vgoncearencu/diy-ltcc/diy-ltcc.brd

## EAGLE design diy-ltcc.brd (2018-06-22)

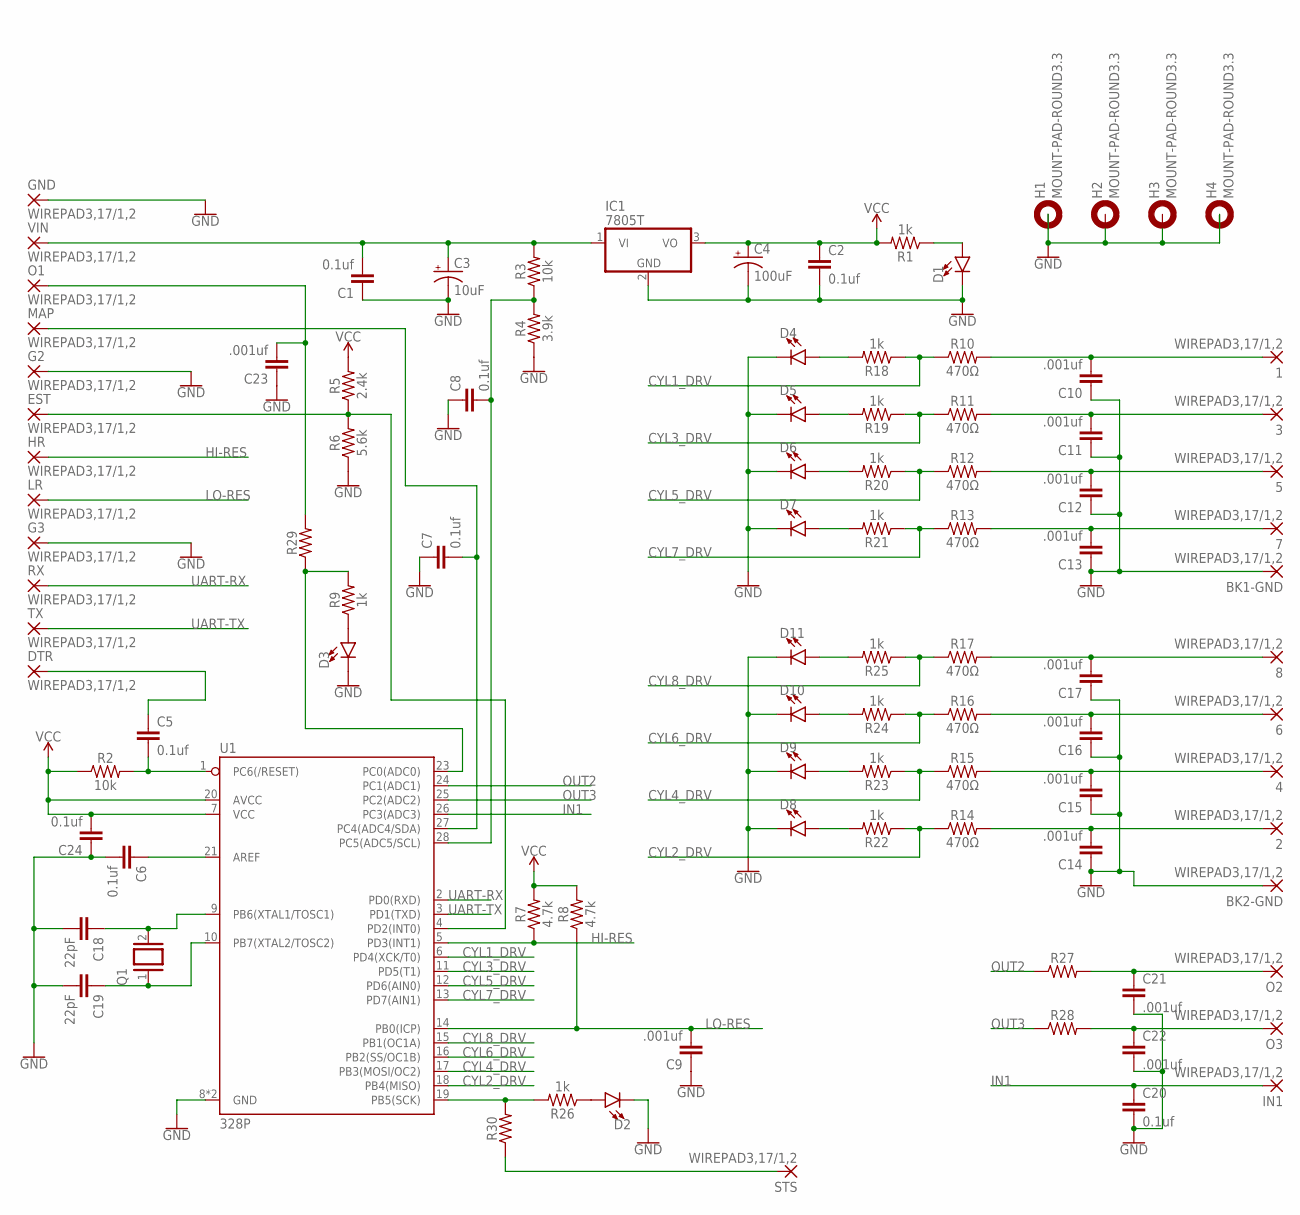
[picture p1: schematic diy-ltcc.sch]

Parts:
1, 2, 3, 4, 5, 6, 7, 8: WIREPAD3,17/1,2; 3,17/1,2
BK1-GND, BK2-GND: WIREPAD3,17/1,2; 3,17/1,2
C1, C2, C5, C6, C7, C8, C20, C24: 0.1uf; CAP-PTH-2.54
C3: 10uF; CPOL-RADIAL-2.5MM-5MM-KIT
C4: 100uF; CPOL-RADIAL-2.5MM-6.5MM
C9, C10, C11, C12, C13, C14, C15, C16, C17, C21, C22, C23: .001uf; CAP-PTH-2.54
C18, C19: 22pF; CAP-PTH-2.54
D1, D2, D3, D4, D5, D6, D7, D8, D9, D10, D11: LED3MM; LED_3MM
DTR: WIREPAD3,17/1,2; 3,17/1,2
EST: WIREPAD3,17/1,2; 3,17/1,2
G2, G3: WIREPAD3,17/1,2; 3,17/1,2
GND: WIREPAD3,17/1,2; 3,17/1,2
H1, H2, H3, H4: MOUNT-PAD-ROUND3.3; 3,3-PAD
HR: WIREPAD3,17/1,2; 3,17/1,2
IC1: 7805T; TO220H
IN1: WIREPAD3,17/1,2; 3,17/1,2
LR: WIREPAD3,17/1,2; 3,17/1,2
MAP: WIREPAD3,17/1,2; 3,17/1,2
O1, O2, O3: WIREPAD3,17/1,2; 3,17/1,2
Q1: XTAL/S; QS
R1, R9, R18, R19, R20, R21, R22, R23, R24, R25, R26: 1k; AXIAL-0.3
R2, R3: 10k; AXIAL-0.3
R4: 3.9k; AXIAL-0.3
R5: 2.4k; AXIAL-0.3
R6: 5.6k; AXIAL-0.3
R7, R8: 4.7k; AXIAL-0.3
R10, R11, R12, R13, R14, R15, R16, R17: 470Ω; AXIAL-0.3
R27, R28, R29, R30: 1KOHM-HORIZ-1/4W-1%; AXIAL-0.3
RX: WIREPAD3,17/1,2; 3,17/1,2
STS: WIREPAD3,17/1,2; 3,17/1,2
TX: WIREPAD3,17/1,2; 3,17/1,2
U1: 328P; DIP28
VIN: WIREPAD3,17/1,2; 3,17/1,2

Connections:
CYL1_DRV: R10.P$1 (1), R18.P$1 (1), U1.6 (PD4(XCK/T0))
CYL2_DRV: R14.P$1 (1), R22.P$1 (1), U1.18 (PB4(MISO))
CYL3_DRV: R11.P$1 (1), R19.P$1 (1), U1.11 (PD5(T1))
CYL4_DRV: R15.P$1 (1), R23.P$1 (1), U1.17 (PB3(MOSI/OC2))
CYL5_DRV: R12.P$1 (1), R20.P$1 (1), U1.12 (PD6(AIN0))
CYL6_DRV: R16.P$1 (1), R24.P$1 (1), U1.16 (PB2(SS/OC1B))
CYL7_DRV: R13.P$1 (1), R21.P$1 (1), U1.13 (PD7(AIN1))
CYL8_DRV: R17.P$1 (1), R25.P$1 (1), U1.15 (PB1(OC1A))
DTR: C5.1, DTR.1
GND: BK1-GND.1, BK2-GND.1, C1.1, C2.2, C3.2 (-), C4.2 (-), C6.2, C7.1, C8.1, C9.1, C10.1, C11.1, C12.1, C13.1, C14.1, C15.1, C16.1, C17.1, C18.2, C19.2, C20.2, C21.2, C22.2, C23.1, C24.1, D1.K (C), D2.K (C), D3.K (C), D4.K (C), D5.K (C), D6.K (C), D7.K (C), D8.K (C), D9.K (C), D10.K (C), D11.K (C), G2.1, G3.1, GND.1, H1.B3,3, H2.B3,3, H3.B3,3, H4.B3,3, IC1.2 (GND), R4.P$1 (1), R6.P$1 (1), U1.8 (GND), U1.22 (GND)
HI-RES: HR.1, R7.P$1 (1), U1.5 (PD3(INT1))
IN1: C20.1, IN1.1, U1.26 (PC3(ADC3))
LO-RES: C9.2, LR.1, R8.P$1 (1), U1.14 (PB0(ICP))
unnamed: D1.A, R1.P$1 (1)
unnamed: C5.2, R2.P$2 (2), U1.1 (PC6(/RESET))
unnamed: C6.1, U1.21 (AREF)
unnamed: C8.2, R3.P$1 (1), R4.P$2 (2), U1.28 (PC5(ADC5/SCL))
unnamed: C1.2, C3.1 (+), IC1.1 (VI), R3.P$2 (2), VIN.1
unnamed: C7.2, MAP.1, U1.27 (PC4(ADC4/SDA))
unnamed: EST.1, R5.P$1 (1), R6.P$2 (2), U1.4 (PD2(INT0))
unnamed: R9.P$2 (2), R29.P$1 (1), U1.23 (PC0(ADC0))
unnamed: D3.A, R9.P$1 (1)
unnamed: 7.1, C13.2, R13.P$2 (2)
unnamed: 5.1, C12.2, R12.P$2 (2)
unnamed: 3.1, C11.2, R11.P$2 (2)
unnamed: 1.1, C10.2, R10.P$2 (2)
unnamed: D2.A, R26.P$1 (1)
unnamed: 8.1, C17.2, R17.P$2 (2)
unnamed: 6.1, C16.2, R16.P$2 (2)
unnamed: 4.1, C15.2, R15.P$2 (2)
unnamed: 2.1, C14.2, R14.P$2 (2)
unnamed: R26.P$2 (2), R30.P$2 (2), U1.19 (PB5(SCK))
unnamed: D8.A, R22.P$2 (2)
unnamed: D9.A, R23.P$2 (2)
unnamed: D10.A, R24.P$2 (2)
unnamed: D11.A, R25.P$2 (2)
unnamed: D7.A, R21.P$2 (2)
unnamed: D6.A, R20.P$2 (2)
unnamed: D5.A, R19.P$2 (2)
unnamed: D4.A, R18.P$2 (2)
unnamed: C18.1, Q1.2, U1.9 (PB6(XTAL1/TOSC1))
unnamed: C19.1, Q1.1, U1.10 (PB7(XTAL2/TOSC2))
unnamed: C23.2, O1.1, R29.P$2 (2)
unnamed: C22.1, O3.1, R28.P$2 (2)
unnamed: C21.1, O2.1, R27.P$2 (2)
unnamed: R30.P$1 (1), STS.1
OUT2: R27.P$1 (1), U1.24 (PC1(ADC1))
OUT3: R28.P$1 (1), U1.25 (PC2(ADC2))
UART-RX: RX.1, U1.2 (PD0(RXD))
UART-TX: TX.1, U1.3 (PD1(TXD))
VCC: C2.1, C4.1 (+), C24.2, IC1.3 (VO), R1.P$2 (2), R2.P$1 (1), R5.P$2 (2), R7.P$2 (2), R8.P$2 (2), U1.7 (VCC), U1.20 (AVCC)

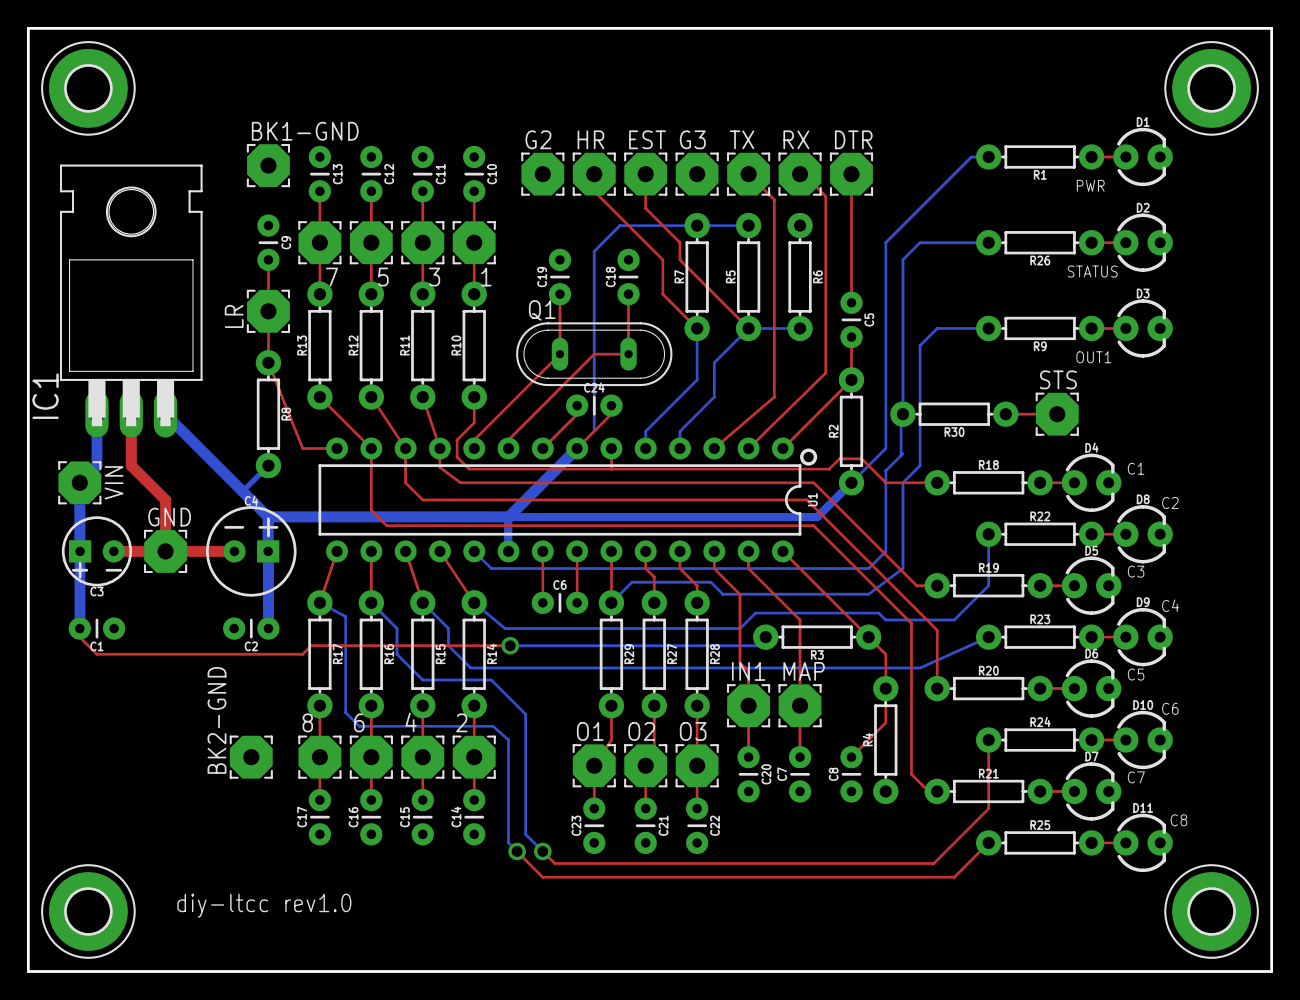
[picture p2: board diy-ltcc.brd from above]

Board: 2 copper layers, 92.1 x 69.8 mm, 98 parts (0 on the bottom side), 51 nets.
