vgoncearencu/diy-ltcc/(commit log)

2018-01-17 Added ign ckt voltage detect for dwell comp
    Fully functional proof of concept.
2018-01-18 Bugfix in getDwell(), added 17v dwell row
    fixed bug in getDwell() where it would return 0 for out of range system voltages
    added 17v dwell row
    ended dwell at tdc to prevent blowing fuse if est signal lost
    [diy_ltcc_0_9_3.ino]
2018-01-24 Tables built by precompiler, move to pgm memory
    All table population handled by precompiler and stored in flash / program memory (thanks dzidav8!)
    Expanded dwellTable to 2d and increased to 16 bit
    Added accelComp table
    Changed voltage detection to calculate millivolts, rounding handled in main loop and passed to external routines as a voltage index
    Numerous other changes & code optimizations
2018-01-24 Most current tested build
    Direct copy of 0.9.7
2018-01-24 Tables built by precompiler, move to pgm memory
    Fix couple typos in comments
    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
    [diy_ltcc_0_9_7.ino]
2018-01-26 Ion sense trigger, fixed timer2 prescaler
    Added ion sense trigger output on pin A1
    Fixed timer2 prescalers that were using prescaler constants for timer1
    [diy_ltcc_0_9_8.ino]
2018-05-08 Removed all floating point math and simulator mode
    Significant rewrite eliminates all floating point math during operation. Removed simulator mode. Reworked uart logging mechanism. MAP input for dwell compensation working but needs testing.
    Starts and runs reliably with no noticeable problems not attributable to other variables. Should be considered highly experimental.
2018-06-13 Initial eagle schematic and pcb layouts
    [diy-ltcc.brd, diy-ltcc.sch]
2018-06-22 Final rev1 ckt and board design
    Untested final rev1 board design and schematic
    [diy-ltcc.brd, diy-ltcc.sch]
